Ardelean-Calin/CANopener/Hardware/can-interface-stm32/stm32-can.pdf

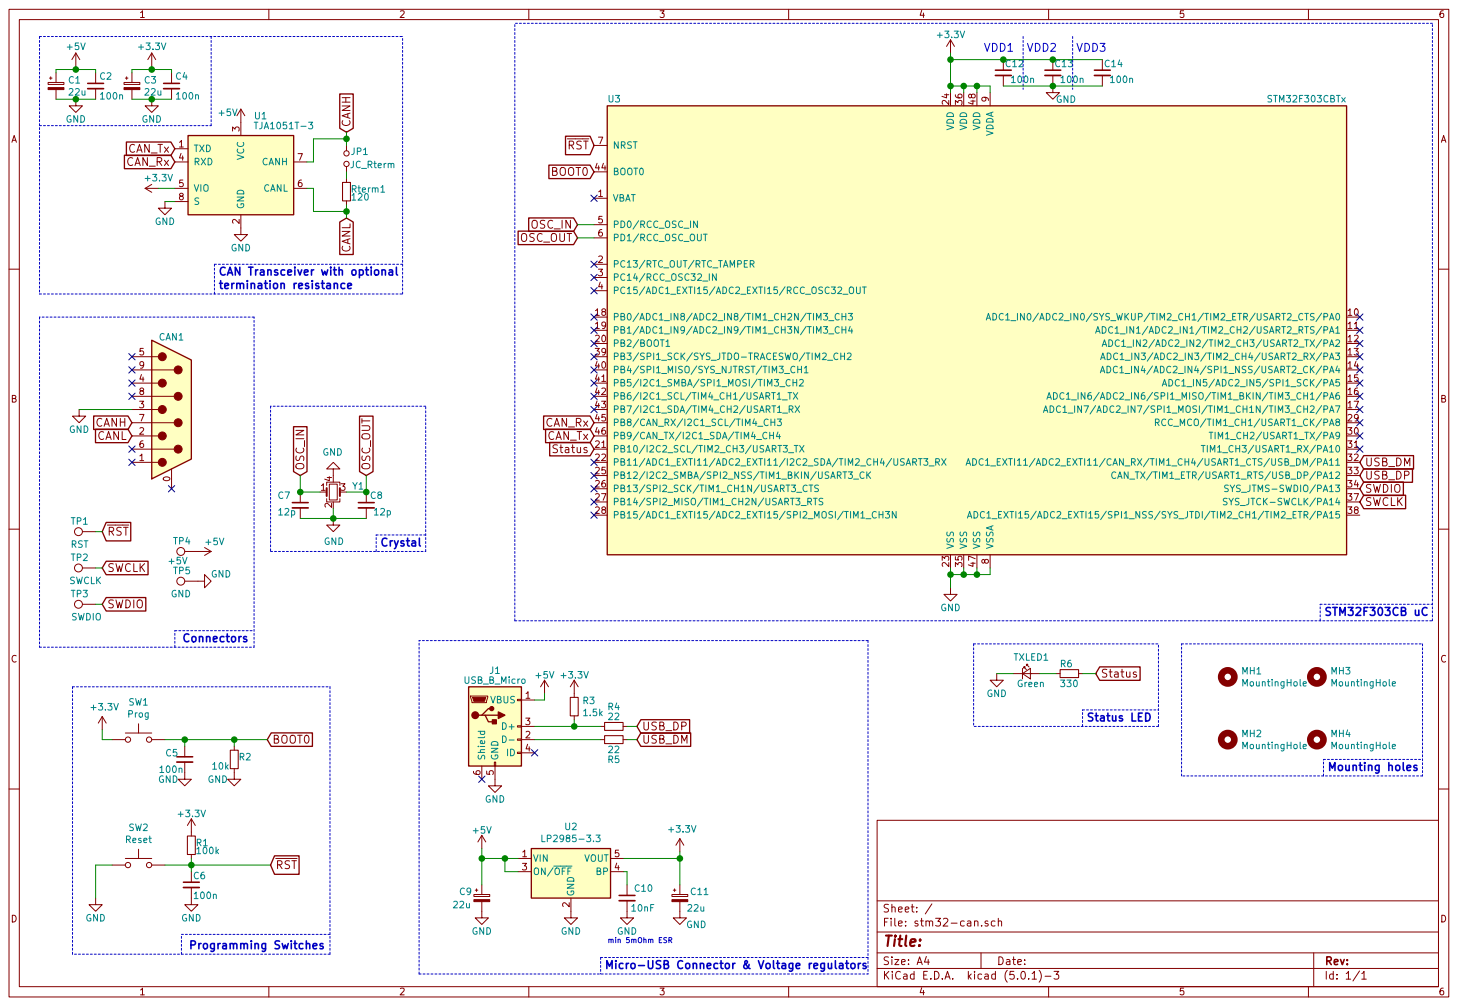
[picture p1: page 1]

3 RXD 4 VIO 5 CANL 6 CANH 7 S

CAN Transceiver with optional termination resistance

2 ON/OFF 3 BP 4 VOUT 5 U2

Id: 1/1 Title: File: stm32-can.sch Sheet: /

Micro-USB Connector & Voltage regulators
