Ardelean-Calin/CANopener/Hardware/can-interface-stm32/stm32-can.kicad_pcb

## KiCad design Hardware/can-interface-stm32/stm32-can.kicad_pcb (2019-07-17)

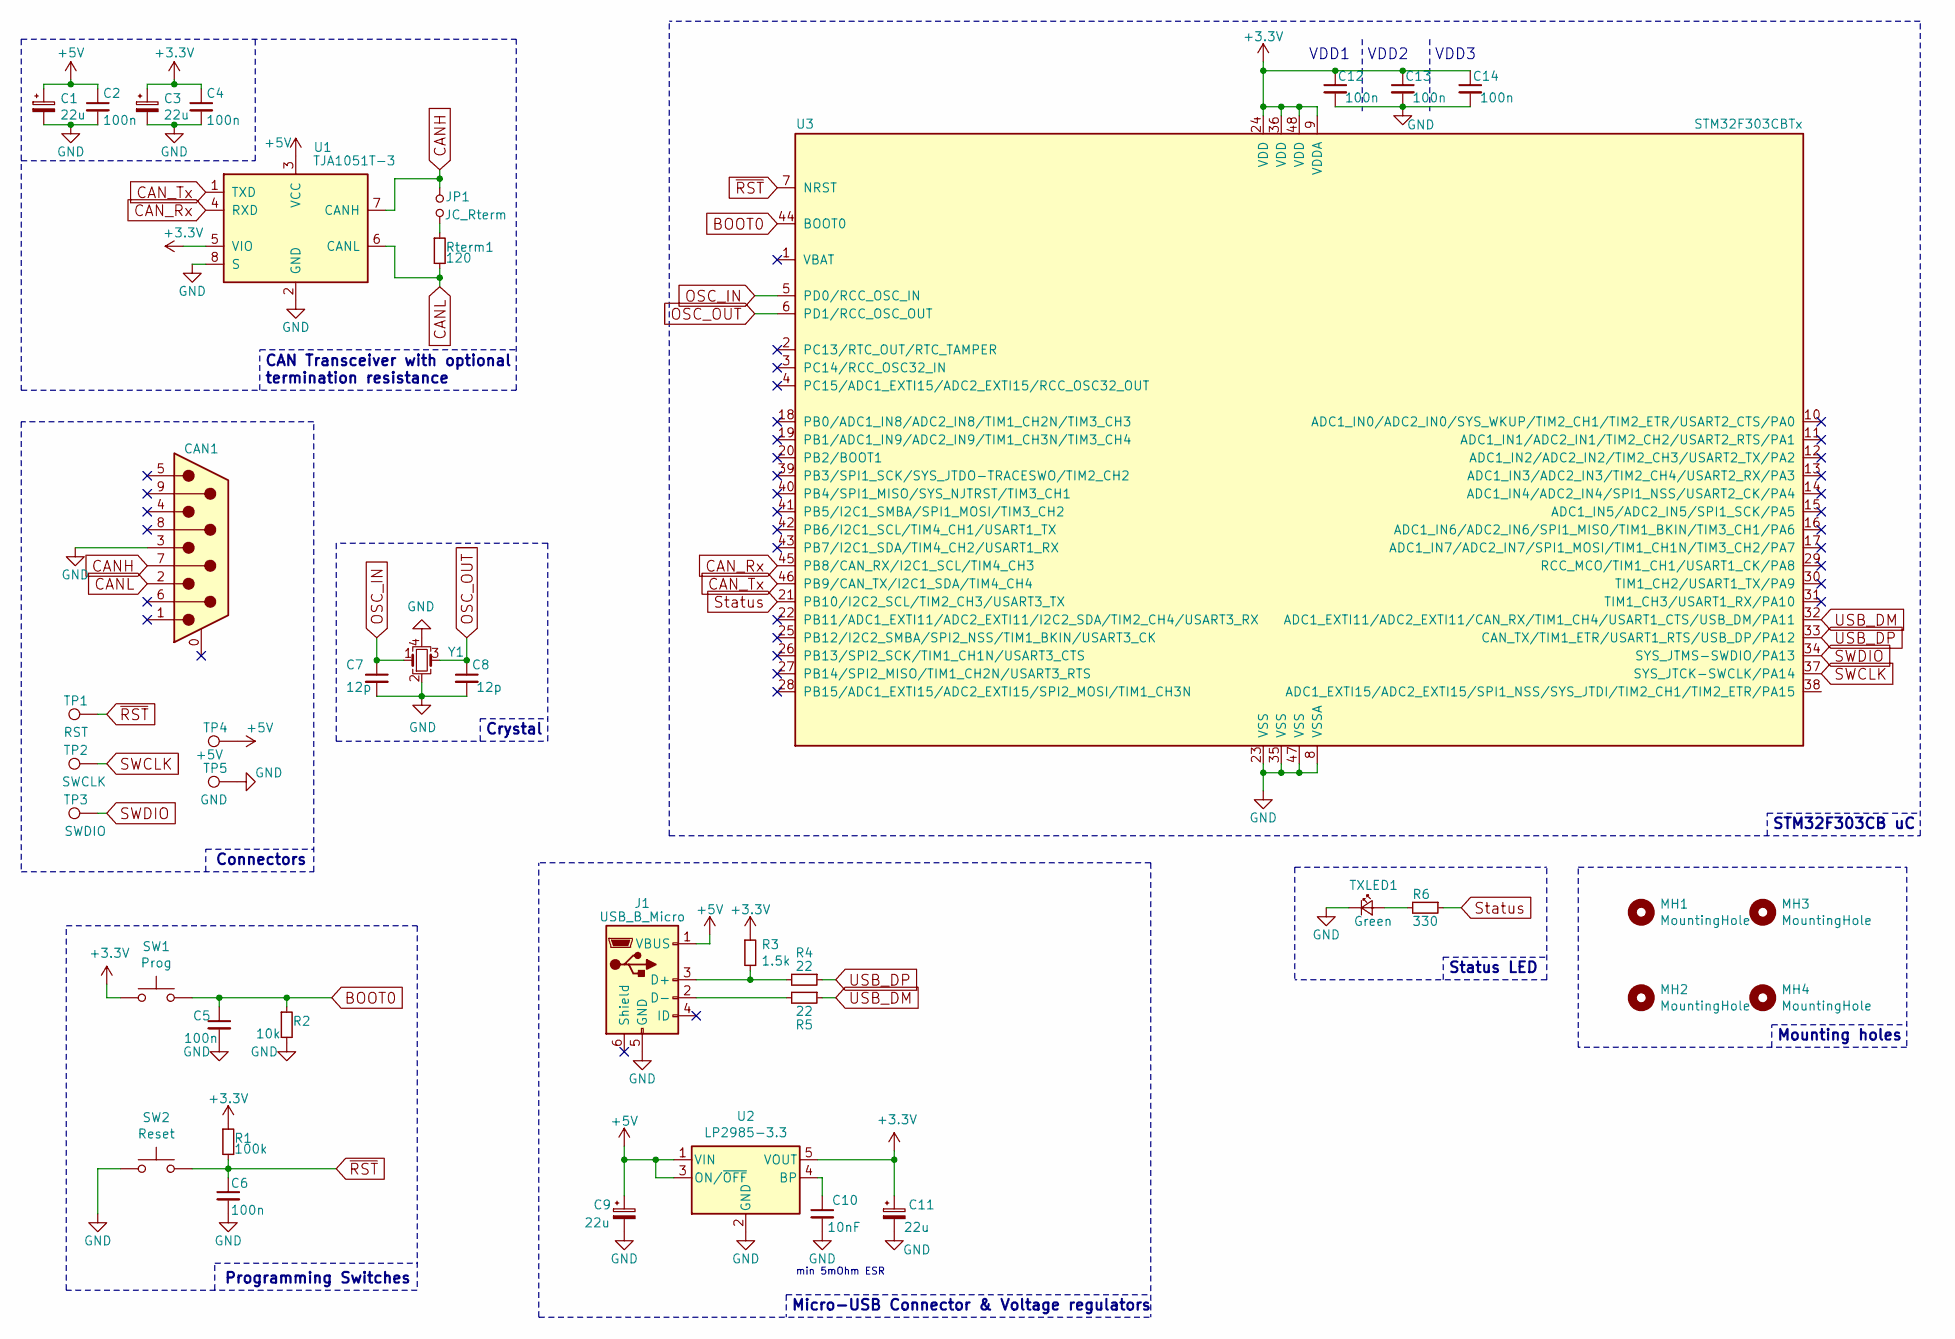
[picture p2: schematic stm32-can.sch]

Parts:
C1, C3, C9, C11: 22u; C_0805_HandSoldering
C2, C4, C5, C6, C12, C13, C14: 100n; C_0603_HandSoldering
C7, C8: 12p; C_0603_HandSoldering
C10: 10nF; C_0603_HandSoldering
CAN1: CAN_Connector; DSUB-9_Male_Horizontal_P2.77x2.84mm_EdgePinOffset4.94mm_Hou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
J1: USB_B_Micro; USB_Micro-B_Wuerth-629105150521_CircularHoles
JP1: JC_Rterm; Pin_Header_Straight_1x02_Pitch2.54mm
MH1, MH2, MH3, MH4: MountingHole; MountingHole_2.2mm_M2_ISO14580_Pad
R1: 100k; R_0603_HandSoldering
R2: 10k; R_0603_HandSoldering
R3: 1.5k; R_0603_HandSoldering
R4, R5: 22; R_0603_HandSoldering
R6: 330; R_0603_HandSoldering
Rterm1: 120; R_0603_HandSoldering
SW1: Prog; SW_SPST_FSMSM
SW2: Reset; SW_SPST_FSMSM
TP1: RST; Measurement_Point_Round-SMD-Pad_Small
TP2: SWCLK; Measurement_Point_Round-SMD-Pad_Small
TP3: SWDIO; Measurement_Point_Round-SMD-Pad_Small
TP4: +5V; Measurement_Point_Round-SMD-Pad_Small
TP5: GND; Measurement_Point_Round-SMD-Pad_Small
TXLED1: Green; LED_0603_HandSoldering
U1: TJA1051T-3; SOIC-8_3.9x4.9mm_Pitch1.27mm
U2: LP2985-3.3; SOT-23-5_HandSoldering
U3: STM32F303CBTx; LQFP-48_7x7mm_Pitch0.5mm
Y1: Crystal_GND24_Small; Crystal_SMD_3225-4pin_3.2x2.5mm_HandSoldering

Connections:
+3V3: C3.1, C4.1, C11.1, C12.1, C13.1, C14.1, R1.1, R3.1, SW1.1, U1.5 (VIO), U2.5 (VOUT), U3.9 (VDDA), U3.24 (VDD), U3.36 (VDD), U3.48 (VDD)
+5V: C1.1, C2.1, C9.1, J1.1 (VBUS), TP4.1, U1.3 (VCC), U2.1 (VIN), U2.3 (ON/~OFF~)
BOOT0: C5.1, R2.1, SW1.2, U3.44 (BOOT0)
CANH: CAN1.7, JP1.2, U1.7 (CANH)
CANL: CAN1.2, Rterm1.2, U1.6 (CANL)
CAN_Rx: U1.4 (RXD), U3.45 (PB8/CAN_RX/I2C1_SCL/TIM4_CH3)
CAN_Tx: U1.1 (TXD), U3.46 (PB9/CAN_TX/I2C1_SDA/TIM4_CH4)
GND: C1.2, C2.2, C3.2, C4.2, C5.2, C6.2, C7.2, C8.2, C9.2, C10.2, C11.2, C12.2, C13.2, C14.2, CAN1.3, J1.5 (GND), R2.2, SW2.1, TP5.1, TXLED1.1 (K), U1.2 (GND), U1.8 (S), U2.2 (GND), U3.8 (VSSA), U3.23 (VSS), U3.35 (VSS), U3.47 (VSS), Y1.2, Y1.4
unnamed: C10.1, U2.4 (BP)
unnamed: J1.2 (D-), R5.2
unnamed: J1.3 (D+), R3.2, R4.2
unnamed: JP1.1, Rterm1.1
unnamed: R6.2, TXLED1.2 (A)
OSC_IN: C7.1, U3.5 (PD0/RCC_OSC_IN), Y1.1
OSC_OUT: C8.1, U3.6 (PD1/RCC_OSC_OUT), Y1.3
SWCLK: TP2.1, U3.37 (SYS_JTCK-SWCLK/PA14)
SWDIO: TP3.1, U3.34 (SYS_JTMS-SWDIO/PA13)
Status: R6.1, U3.21 (PB10/I2C2_SCL/TIM2_CH3/USART3_TX)
USB_DM: R5.1, U3.32 (ADC1_EXTI11/ADC2_EXTI11/CAN_RX/TIM1_CH4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)
USB_DP: R4.1, U3.33 (CAN_TX/TIM1_ETR/USART1_RTS/USB_DP/PA12)
~RST: C6.1, R1.2, SW2.2, TP1.1, U3.7 (NRST)

Notes on the sheet:
VDD1
VDD2
VDD3
Micro-USB Connector & Voltage regulators
CAN Transceiver with optional termination resistance
Status LED
Connectors
STM32F303CB uC
min 5mOhm ESR
Mounting holes
Programming Switches
Crystal

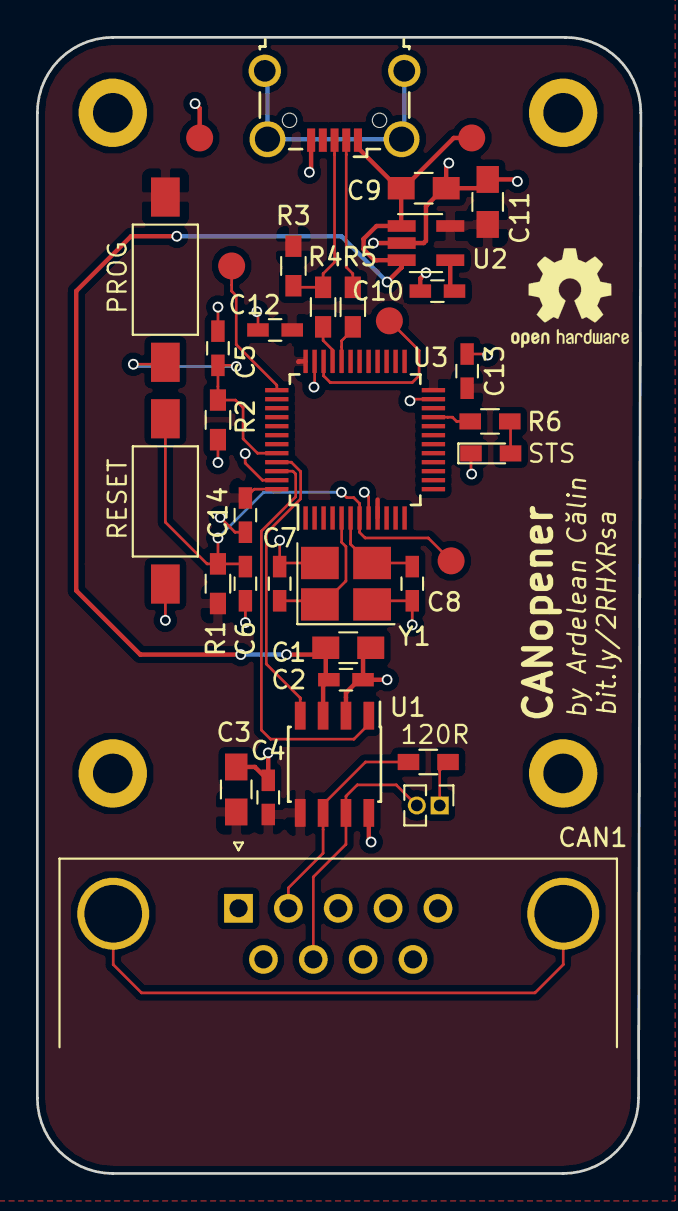
[picture p3: board stm32-can.kicad_pcb from above]

Board: 2 copper layers, 33.5 x 63.1 mm, 40 parts (0 on the bottom side), 21 nets.
