Ardelean-Calin/CANopener/Hardware/black-magic-probe-debugger/blackmagicprobe/blackmagicprobe.kicad_pcb

## KiCad design Hardware/black-magic-probe-debugger/blackmagicprobe/blackmagicprobe.kicad_pcb (2019-07-17)

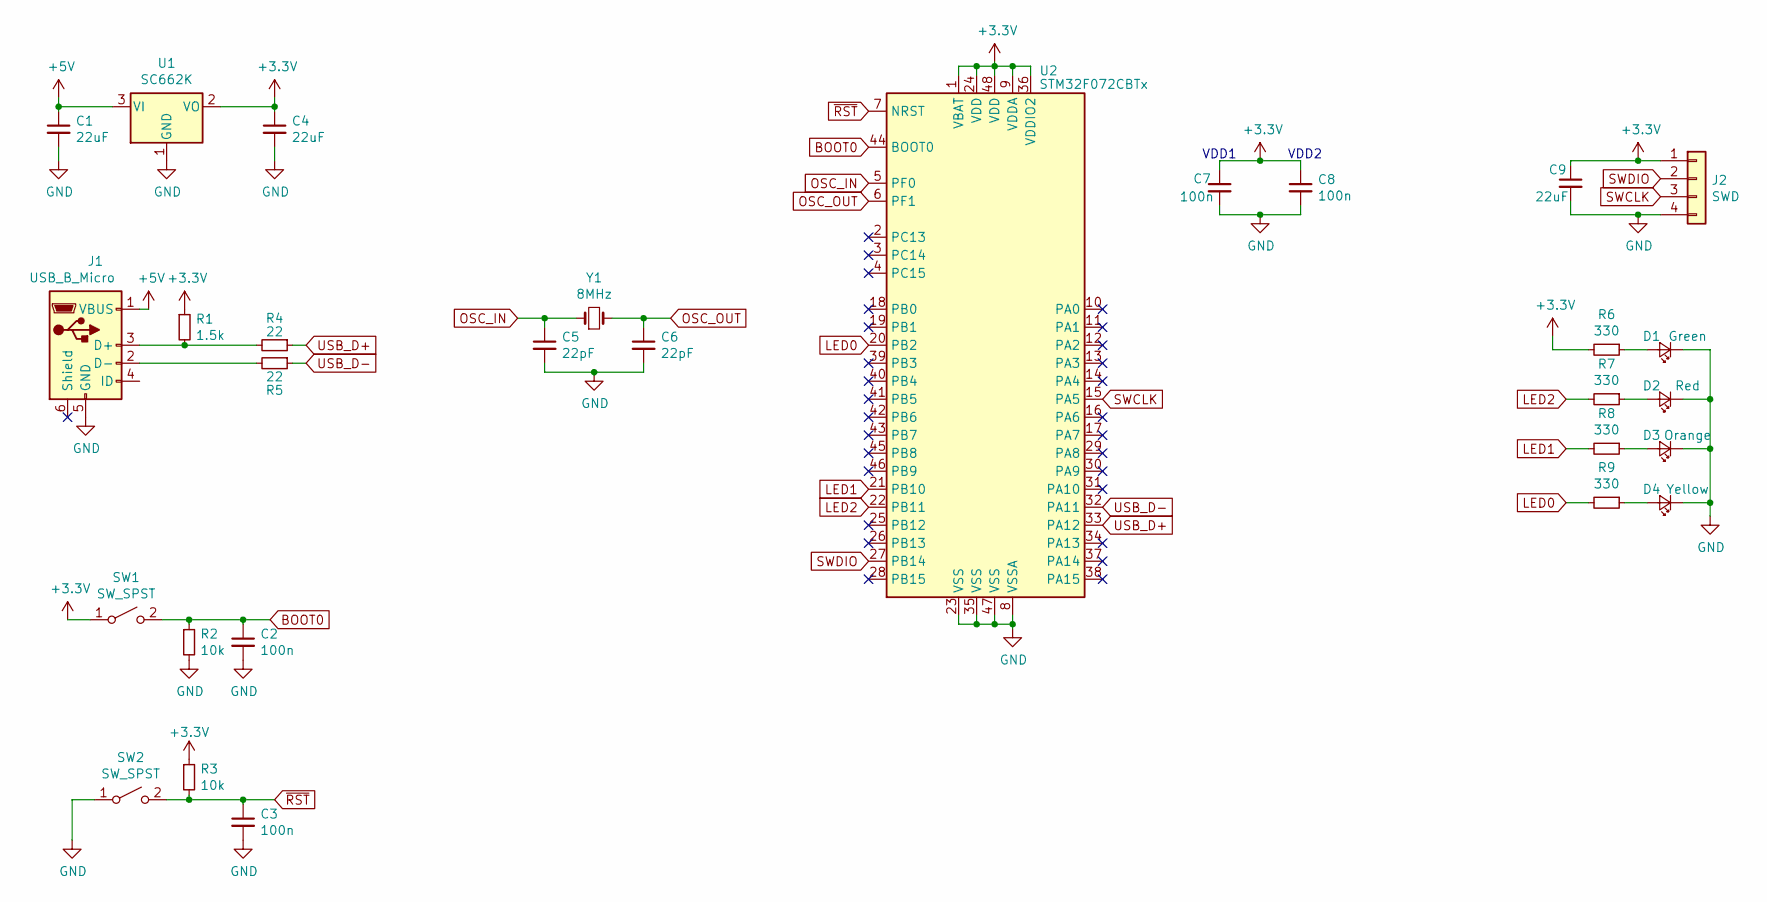
[picture p4: schematic blackmagicprobe.sch]

Parts:
C1, C4, C9: 22uF; C_0805
C2, C3, C7, C8: 100n; C_0603
C5, C6: 22pF; C_0603
D1: Green; LED_0603
D2: Red; LED_0603
D3: Orange; LED_0603
D4: Yellow; LED_0603
J1: USB_B_Micro; USB_Micro-B_Wuerth-629105150521
J2: SWD; Pin_Header_Angled_1x04_Pitch2.54mm
R1: 1.5k; R_0603
R2, R3: 10k; R_0603
R4, R5: 22; R_0603
R6, R7, R8, R9: 330; R_0603
SW1, SW2: SW_SPST; SW_SPST_B3U-3000P-B
U1: SC662K; SOT-23_Handsoldering
U2: STM32F072CBTx; LQFP-48_7x7mm_Pitch0.5mm
Y1: 8MHz; Crystal_SMD_5032-2pin_5.0x3.2mm

Connections:
+3V3: C4.1, C7.1, C8.1, C9.1, J2.1, R1.1, R3.1, R6.2, SW1.1 (A), U1.2 (VO), U2.1 (VBAT), U2.9 (VDDA), U2.24 (VDD), U2.36 (VDDIO2), U2.48 (VDD)
+5V: C1.1, J1.1 (VBUS), U1.3 (VI)
BOOT0: C2.1, R2.1, SW1.2 (B), U2.44 (BOOT0)
GND: C1.2, C2.2, C3.2, C4.2, C5.2, C6.2, C7.2, C8.2, C9.2, D1.1 (K), D2.1 (K), D3.1 (K), D4.1 (K), J1.5 (GND), J2.4, R2.2, SW2.1 (A), U1.1 (GND), U2.8 (VSSA), U2.23 (VSS), U2.35 (VSS), U2.47 (VSS)
LED0: R9.2, U2.20 (PB2)
LED1: R8.2, U2.21 (PB10)
LED2: R7.2, U2.22 (PB11)
unnamed: D1.2 (A), R6.1
unnamed: D2.2 (A), R7.1
unnamed: D3.2 (A), R8.1
unnamed: D4.2 (A), R9.1
unnamed: J1.2 (D-), R5.2
unnamed: J1.3 (D+), R1.2, R4.2
OSC_IN: C5.1, U2.5 (PF0), Y1.1
OSC_OUT: C6.1, U2.6 (PF1), Y1.2
SWCLK: J2.3, U2.15 (PA5)
SWDIO: J2.2, U2.27 (PB14)
USB_D+: R4.1, U2.33 (PA12)
USB_D-: R5.1, U2.32 (PA11)
~RST: C3.1, R3.2, SW2.2 (B), U2.7 (NRST)

Notes on the sheet:
VDD1
VDD2

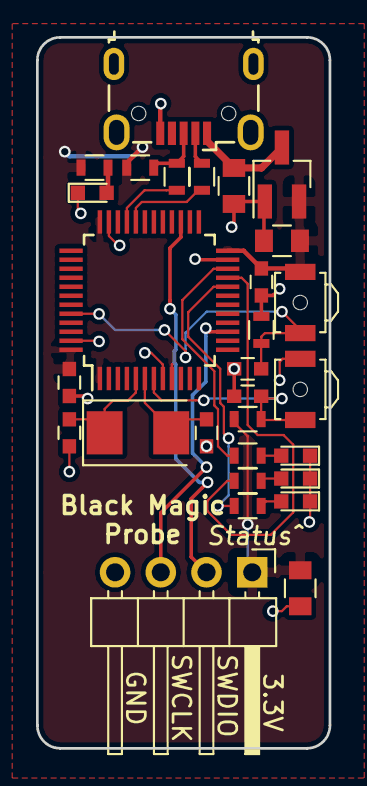
[picture p5: board blackmagicprobe.kicad_pcb from above]

Board: 2 copper layers, 16.3 x 39.5 mm, 29 parts (0 on the bottom side), 20 nets.
