Ardelean-Calin/CANopener/Src/main.c

/**
  ******************************************************************************
  * @file           : main.c
  * @brief          : Main program body
  ******************************************************************************
  * This notice applies to any and all portions of this file
  * that are not between comment pairs USER CODE BEGIN and
  * USER CODE END. Other portions of this file, whether 
  * inserted by the user or by software development tools
  * are owned by their respective copyright owners.
  *
  * Copyright (c) 2018 STMicroelectronics International N.V. 
  * All rights reserved.
  *
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
  ******************************************************************************
  */
/* Includes ------------------------------------------------------------------*/
#include "main.h"
#include "stm32f3xx_hal.h"
#include "cmsis_os.h"
#include "usb_device.h"
#include "usbd_cdc_if.h"
#include "RTE.h"
#include "typedefs.h"
#include "cobs.h"
static const char *cResponseOK = "Ardelean Calin";
static uint8_t ucStatusCount = 0;
void SystemClock_Config(void);
static void MX_GPIO_Init(void);
static void MX_CAN_Init(void);

void USB_DEVICE_MasterHardReset(void);

// Tasks
void vUSBRxDecoderTask(void *const pvParameters);
void vUSBTransmitTask(void *const pvParameters);
void vCANRxEncoderTask(void *const pvParameters);
void vCANTransmitTask(void *const pvParameters);
void vCANReceiveTask(void *const pvParameters);
void vStatusBlinkTask(void *const pvParameters);

/**
  * @brief  The application entry point.
  *
  * @retval None
  */
int main(void)
{

    /* MCU Configuration----------------------------------------------------------*/

    /* Reset of all peripherals, Initializes the Flash interface and the Systick. */
    HAL_Init();

    /* Configure the system clock */
    SystemClock_Config();

    /* Initialize all configured peripherals */
    MX_GPIO_Init();
    MX_CAN_Init();

    /* init code for USB_DEVICE */
    #ifdef DEBUG
    USB_DEVICE_MasterHardReset();
    #endif
    MX_USB_DEVICE_Init();

    // Enable this for Tracealyzer traces
    #ifdef DEBUG
    vTraceEnable(TRC_START);
    #endif

    // Create tasks
    xTaskCreate(vUSBRxDecoderTask, "USB_RX_DECODER", 64, NULL, 3, NULL);
    xTaskCreate(vUSBTransmitTask, "USB_TRANSMIT", 64, NULL, 2, NULL);
    xTaskCreate(vCANRxEncoderTask, "CAN_RX_ENCODER", 64, NULL, 2, NULL);
    xTaskCreate(vCANTransmitTask, "CAN_TRANSMIT", 64, NULL, 3, NULL);
    xTaskCreate(vCANReceiveTask, "CAN_RECEIVE", 64, NULL, 1, NULL);
    xTaskCreate(vStatusBlinkTask, "STATUS_TASK", 64, NULL, 1, NULL);


    /* USER CODE BEGIN RTOS_QUEUES */
    xUSBReceiveQueue = xQueueCreate(5, USB_ENC_PACKET_SIZE);
    xUSBTransmitQueue = xQueueCreate(5, sizeof(xUSBTxFrame_t *));
    xCANReceiveQueue = xQueueCreate(CAN_RX_BUFFER_SIZE, sizeof(CanRxMsgTypeDef *));
    xCANTransmitQueue = xQueueCreate(CAN_TX_BUFFER_SIZE, sizeof(CanTxMsgTypeDef *));
    // Add queues to registry
    vQueueAddToRegistry(xUSBReceiveQueue, "USB Receive Queue");
    vQueueAddToRegistry(xUSBTransmitQueue, "USB Transmit Queue");
    vQueueAddToRegistry(xCANReceiveQueue, "CAN Receive Queue");
    vQueueAddToRegistry(xCANTransmitQueue, "CAN Transmit Queue");
    /* USER CODE END RTOS_QUEUES */

    /* Start scheduler */
    vTaskStartScheduler();

    /* We should never get here as control is now taken by the scheduler */

    while (1)
    {
    }
}

void vUSBTransmitTask(void *const pvParameters)
{
    uint8_t pcUSBEncodedMessage[USB_ENC_PACKET_SIZE];
    xUSBTxFrame_t *pxUSBTransmitFrame;
    for (;;)
    {
        xQueueReceive(xUSBTransmitQueue, &pxUSBTransmitFrame, portMAX_DELAY);

        // Fill unused bytes with 0xFF
        if (pxUSBTransmitFrame->ucSize < USB_DEC_PACKET_SIZE)
        {
            memset(&pxUSBTransmitFrame->pucData[pxUSBTransmitFrame->ucSize], 255U, USB_DEC_PACKET_SIZE - pxUSBTransmitFrame->ucSize);
        }

        // Encode using COBS encoding algorithm
        ucStuffData(&pxUSBTransmitFrame->pucData[0], USB_DEC_PACKET_SIZE, &pcUSBEncodedMessage[0]);
        pcUSBEncodedMessage[USB_ENC_PACKET_SIZE - 1] = 0U;

        // Now we send the encoded message via USB.
        CDC_Transmit_FS(pcUSBEncodedMessage, USB_ENC_PACKET_SIZE);
    }
}

void vUSBRxDecoderTask(void *const pvParameters)
{
    uint8_t pcEncodedUSBMessage[USB_ENC_PACKET_SIZE];
    uint8_t pcDecodedUSBMessage[USB_DEC_PACKET_SIZE];
    uint8_t ucType;
    uint8_t ucIsExtended;
    uint32_t ucCanID;
    uint8_t ucDLC;
    uint8_t ucRequestedBaudrate;

    CanTxMsgTypeDef *pxTXMessage;
    pxTXMessage = &xCANTransmitBuffer[0];

    xUSBTxFrame_t xUSBTransmitFrame;
    xUSBTxFrame_t *pxUSBTransmitFrame = &xUSBTransmitFrame;

    for (;;)
    {
        // Wait forever for an item in the queue to come.
        xQueueReceive(xUSBReceiveQueue, pcEncodedUSBMessage, portMAX_DELAY);
        // Decode the COBS-encoded data
        ucUnStuffData(pcEncodedUSBMessage, USB_ENC_PACKET_SIZE, pcDecodedUSBMessage);

        // What command was requested?
        ucType = pcDecodedUSBMessage[0];

        switch (ucType)
        {
        case RX_CAN_SEND:
            // Master wants us to send a message
            ucIsExtended = pcDecodedUSBMessage[1];
            ucCanID = (pcDecodedUSBMessage[2] << 24) +
                      (pcDecodedUSBMessage[3] << 16) +
                      (pcDecodedUSBMessage[4] << 8) +
                      (pcDecodedUSBMessage[5]);
            ucDLC = pcDecodedUSBMessage[6];
            pxTXMessage->DLC = ucDLC;

            if (ucIsExtended)
            {
                pxTXMessage->IDE = CAN_ID_EXT;
                pxTXMessage->ExtId = ucCanID;
            }
            else
            {
                pxTXMessage->IDE = CAN_ID_STD;
                pxTXMessage->StdId = ucCanID;
            }
            pxTXMessage->RTR = (uint32_t)CAN_RTR_DATA;

            memcpy(&pxTXMessage->Data[0], &pcDecodedUSBMessage[7], 8);
            xQueueSend(xCANTransmitQueue, (void *)&pxTXMessage, 0);
            break;
        case RX_PING_REQ:
            xUSBTransmitFrame.pucData[0] = TX_PONG_SEND;
            memcpy(xUSBTransmitFrame.pucData + 1, (void *)cResponseOK, strlen(cResponseOK));

            xUSBTransmitFrame.ucSize = strlen(cResponseOK) + 1;
            xQueueSend(xUSBTransmitQueue, (void *)&pxUSBTransmitFrame, 0U);
            break;
        case RX_CAN_SET_BAUDRATE:
            ucRequestedBaudrate = pcDecodedUSBMessage[1];
            if (ucRequestedBaudrate < CAN_BAUDRATE_NOT_SUPPORTED)
            {
                /* Request enter initialisation */
                SET_BIT(hcan.Instance->MCR, CAN_MCR_INRQ);
                /* Set baudrate */
                MODIFY_REG(hcan.Instance->BTR, 0x00FFFFFF, (uint32_t)(CAN_BTR_VALUES[ucRequestedBaudrate]));
                /* Request leave initialisation */
                CLEAR_BIT(hcan.Instance->MCR, CAN_MCR_INRQ);
            }
            break;
        default:
            break;
        }
    }
}

/*
 * This task encodes the received CAN frame into an USB message and sends it to
 * the USB transmit queue.
 */
void vCANRxEncoderTask(void *const pvParameters)
{
    CanRxMsgTypeDef *xCANRxMessage;
    uint32_t ucCanID;

    xUSBTxFrame_t xUSBTransmitFrame;
    xUSBTxFrame_t *pxUSBTransmitFrame = &xUSBTransmitFrame;

    for (;;)
    {
        // Wait forever for a new CAN message
        xQueueReceive(xCANReceiveQueue, &xCANRxMessage, portMAX_DELAY);

        // Type/Command
        xUSBTransmitFrame.pucData[0] = TX_CAN_RECV;
        // Flags - Extended
        xUSBTransmitFrame.pucData[1] = xCANRxMessage->IDE >> 2;
        // CAN ID
        if (xCANRxMessage->IDE)
        {
            // Extended ID
            ucCanID = xCANRxMessage->ExtId;
        }
        else
        {
            ucCanID = xCANRxMessage->StdId;
        }
        xUSBTransmitFrame.pucData[2] = (ucCanID & 0xFF000000) >> 24;
        xUSBTransmitFrame.pucData[3] = (ucCanID & 0x00FF0000) >> 16;
        xUSBTransmitFrame.pucData[4] = (ucCanID & 0x0000FF00) >> 8;
        xUSBTransmitFrame.pucData[5] = (ucCanID & 0x000000FF);
        // DLC
        xUSBTransmitFrame.pucData[6] = xCANRxMessage->DLC;
        // Data
        memcpy(&xUSBTransmitFrame.pucData[7], &xCANRxMessage->Data[0], 8U);

        xUSBTransmitFrame.ucSize = USB_DEC_PACKET_SIZE;

        // Send to transmit task
        xQueueSend(xUSBTransmitQueue, (void *)&pxUSBTransmitFrame, 0U);
    }
}
/*
 * This task transmits the CAN messages scheduled for transmission.
 * TODO Have the ringbuffer index get locked and unlocked using a binary semaphore or something
 */
void vCANTransmitTask(void *const pvParameters)
{
    CanTxMsgTypeDef *xCANTxMessage = hcan.pTxMsg;
    for (;;)
    {
        xQueueReceive(xCANTransmitQueue, &xCANTxMessage, portMAX_DELAY);
        hcan.pTxMsg = xCANTxMessage;
        // TODO What timeout should I put?
        HAL_CAN_Transmit(&hcan, 0);
        // Blink status LED 10 times
        ucStatusCount = 10U;
    }
}

/*
 * CAN Receive Task. Continously checks for new CAN message. Lowest priority
 * as to preemtively shedule the processing to higher priority tasks
 */
void vCANReceiveTask(void *const pvParameters)
{
    // TODO Maybe also monitor FIFO overrun errors? HAL_CAN_ERROR_FOV0
    CanRxMsgTypeDef *xCANRxMessage = &xCANReceiveBuffer[0];
    // Basically set in which structure to receive the CAN message
    hcan.pRxMsg = xCANRxMessage;

    for (;;)
    {
        // Only if we have a message in the receive queue
        if (hcan.Instance->RF0R & 0b11)
        {
            // Read the message from the FIFO.
            HAL_CAN_Receive(&hcan, CAN_FIFO0, 0U);
            // Blink status LED 10 times
            ucStatusCount = 10U;
            // Send a pointer to the CAN RX message as payload since it's big
            // and would take a lot of time to just copy it.
            xQueueSend(xCANReceiveQueue, (void *)&xCANRxMessage, 0U);
        }
    }
}

/*
 * Status LED Task. Will blink the LED 10 times.
 */
void vStatusBlinkTask(void *const pvParameters)
{
    for (;;)
    {
        if (ucStatusCount)
        {
            HAL_GPIO_TogglePin(GPIOB, GPIO_PIN_10);
            ucStatusCount--;
        }
        else 
        {
            HAL_GPIO_WritePin(GPIOB, GPIO_PIN_10, GPIO_PIN_SET);
        }

        vTaskDelay(pdMS_TO_TICKS(35));
    }
}

void USB_DEVICE_MasterHardReset(void)
{
    GPIO_InitTypeDef GPIO_InitStruct;
    GPIO_InitStruct.Pin = GPIO_PIN_12;
    GPIO_InitStruct.Mode = GPIO_MODE_OUTPUT_PP;
    GPIO_InitStruct.Pull = GPIO_PULLDOWN;
    GPIO_InitStruct.Speed = GPIO_SPEED_FREQ_HIGH;
    HAL_GPIO_Init(GPIOA, &GPIO_InitStruct);
    HAL_GPIO_WritePin(GPIOA, GPIO_PIN_12, GPIO_PIN_RESET);
    HAL_Delay(1000);
}

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
/**
  * @brief  Period elapsed callback in non blocking mode
  * @note   This function is called  when TIM3 interrupt took place, inside
  * HAL_TIM_IRQHandler(). It makes a direct call to HAL_IncTick() to increment
  * a global variable "uwTick" used as application time base.
  * @param  htim : TIM handle
  * @retval None
  */
void HAL_TIM_PeriodElapsedCallback(TIM_HandleTypeDef *htim)
{
    if (htim->Instance == TIM3)
    {
        HAL_IncTick();
    }
}

/**
  * @brief  This function is executed in case of error occurrence.
  * @param  file: The file name as string.
  * @param  line: The line in file as a number.
  * @retval None
  */
void _Error_Handler(char *file, int line)
{
    /* USER CODE BEGIN Error_Handler_Debug */
    /* User can add his own implementation to report the HAL error return state */
    while (1)
    {
    }
    /* USER CODE END Error_Handler_Debug */
}

#ifdef USE_FULL_ASSERT
/**
  * @brief  Reports the name of the source file and the source line number
  *         where the assert_param error has occurred.
  * @param  file: pointer to the source file name
  * @param  line: assert_param error line source number
  * @retval None
  */
void assert_failed(uint8_t *file, uint32_t line)
{
    /* USER CODE BEGIN 6 */
    /* User can add his own implementation to report the file name and line number,
     tex: printf("Wrong parameters value: file %s on line %d\r\n", file, line) */
    /* USER CODE END 6 */
}
#endif /* USE_FULL_ASSERT */

/**
  * @}
  */

/**
  * @}
  */

/************************ (C) COPYRIGHT STMicroelectronics *****END OF FILE****/
