Ardelean-Calin/CANopener/OpenCAN_CubeMX.ioc

Mcu.UserName=STM32F303CBTx
PA11.Signal=USB_DM
PA12.Signal=USB_DP
PA13.Signal=SYS_JTMS-SWDIO
PA14.Signal=SYS_JTCK-SWCLK
PB8.Signal=CAN_RX
PB9.Signal=CAN_TX
PF0-OSC_IN.Signal=RCC_OSC_IN
