Ardelean-Calin/CANopener/(commit log)

2018-06-25 Initial commit. Working USB RX task
    [OpenCAN Debug.cfg]
2018-09-26 Working CAN receive
    [opencan.cfg]
2018-09-29 Incipient Makefile
    [OpenCAN Debug.cfg]
2018-09-29 Now completely able to debug using VSCode
    [OpenCAN Debug.cfg]
2018-09-30 Added COBS frame-encoding algorithm.
2018-09-30 Switched to COBS frame-encoding algorithm.
2018-09-30 Switched to loopback mode for RX testing.
2018-10-01 Changed path of OpenOCD again. Really need to find a better solution
    [OpenCAN Debug.cfg]
2018-10-01 Removed absolute path of stlink config file
    [OpenCAN Debug.cfg, stlink-v2.cfg]
2018-10-01 Removed unused OpenOCD config file
    [opencan.cfg]
2018-10-15 Switched to normal mode for CAN controller
2018-11-18 Added Software Timer for Status LED & optimized priorities.
2018-11-19 Disabled software-timer for LED blinking; Using task
2018-11-20 Disabled I2C HAL Driver
2019-06-23 Added flashing capability using Black Magic Probe
2019-07-11 Added trace of sending and receiving a CAN mesage.
2019-07-11 Added tracealyzer trace recording in DEBUG mode
2019-07-13 Maybe better interrupt handling.
2019-07-17 Disertatia predata
    [blackmagicprobe.kicad_pcb, blackmagicprobe.sch, bom.csv, stm32-can-2018-07-23-13-42-09.sch, stm32-can-2018-09-20-17-26-24.sch, stm32-can-2018-11-04-17-35-56.sch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]
